labdvm/mHAT-V2/README.md

# mHAT-V2
SX1255 TMO mini-HAT with BPF

- SAW Bandpass filters:
- RX, TA0665A (https://www.aliexpress.com/item/1005011831789075.html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)
- TX, TA2490A (https://www.aliexpress.com/item/1005011831747244.html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)

# Order from here:
- <a href="https://www.pcbway.com/project/shareproject/mHAT_V2_SX1255_TMO_mini_HAT_0cc71a80.html">PCB from PCBWay</a>
