labdvm/mHAT-V2/mHAT V2.png

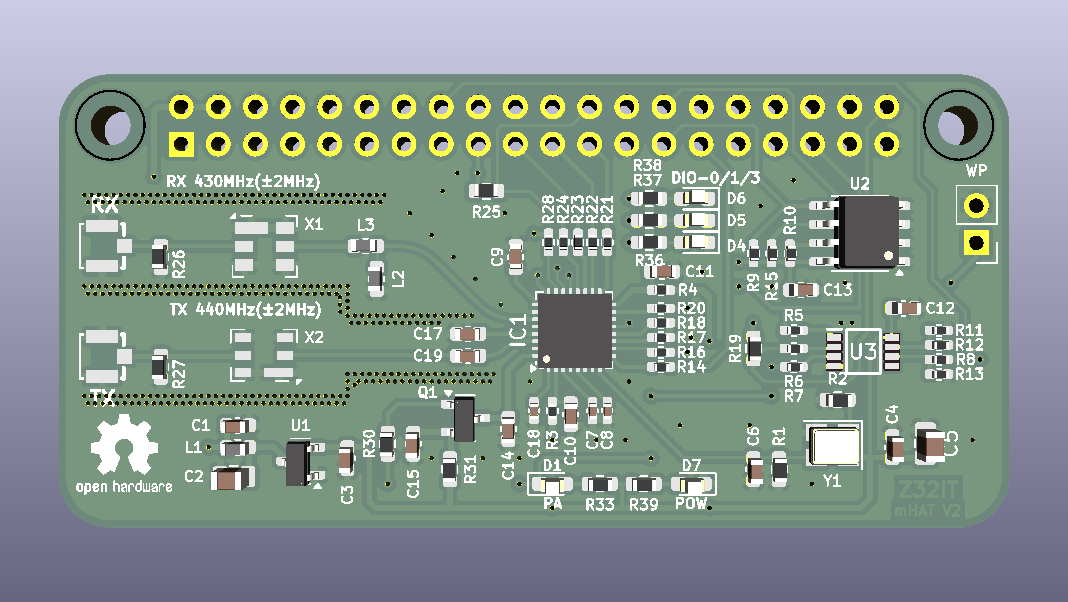
mHAT V2.png
