labdvm/mHAT-V2/mHAT V2.pdf

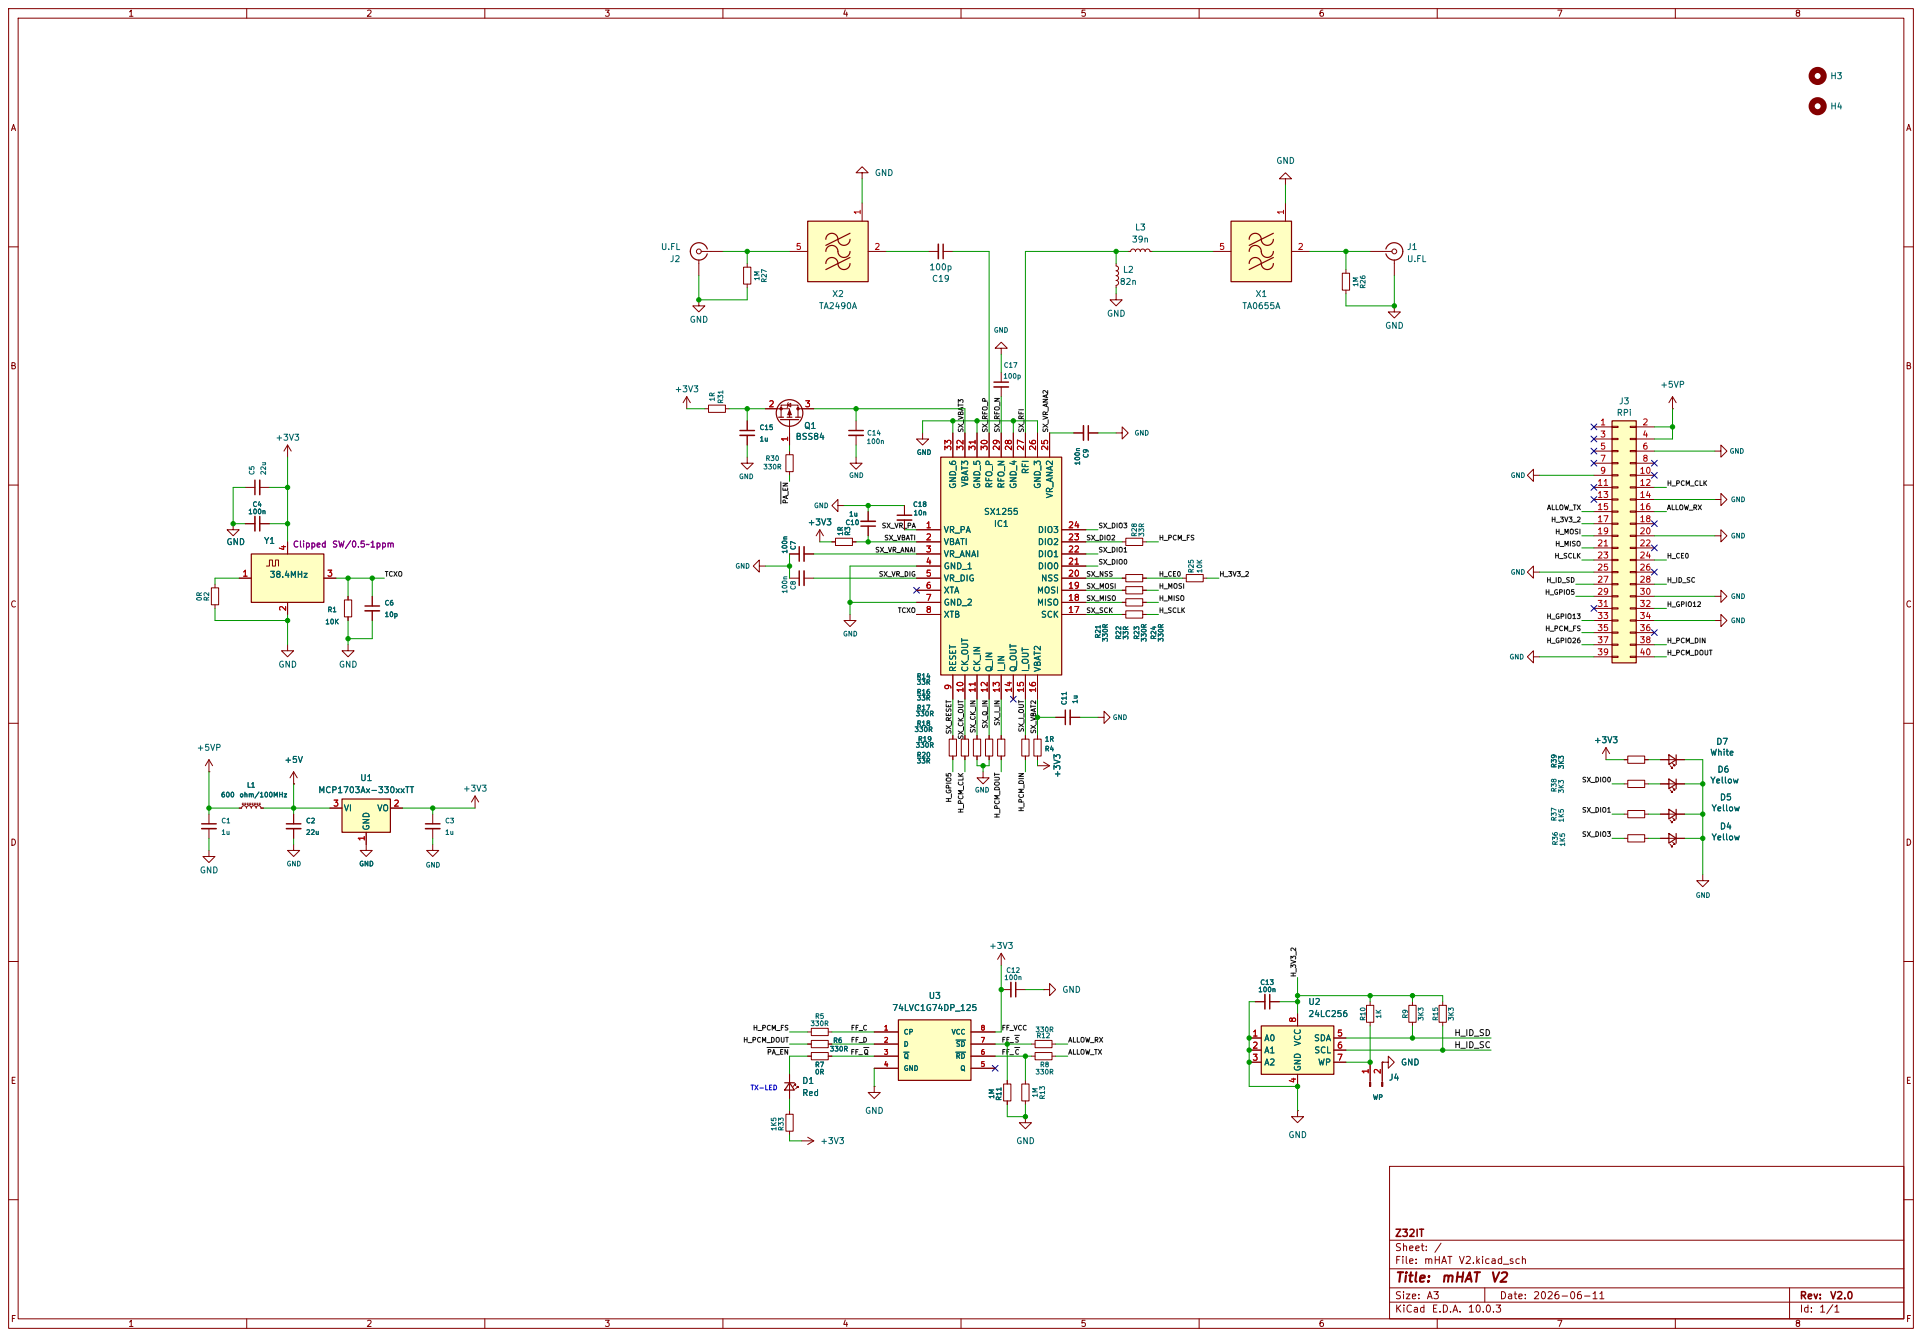
[picture p2: page 1]

Size: A3 | Rev: V2.0 | F Date: 2026-06-11
KiCad E.D.A. 10.0.3 | Id: 1/1
