labdvm/mHAT-V2/mHAT V2.kicad_pcb

## KiCad design mHAT V2.kicad_pcb (2026-06-11)

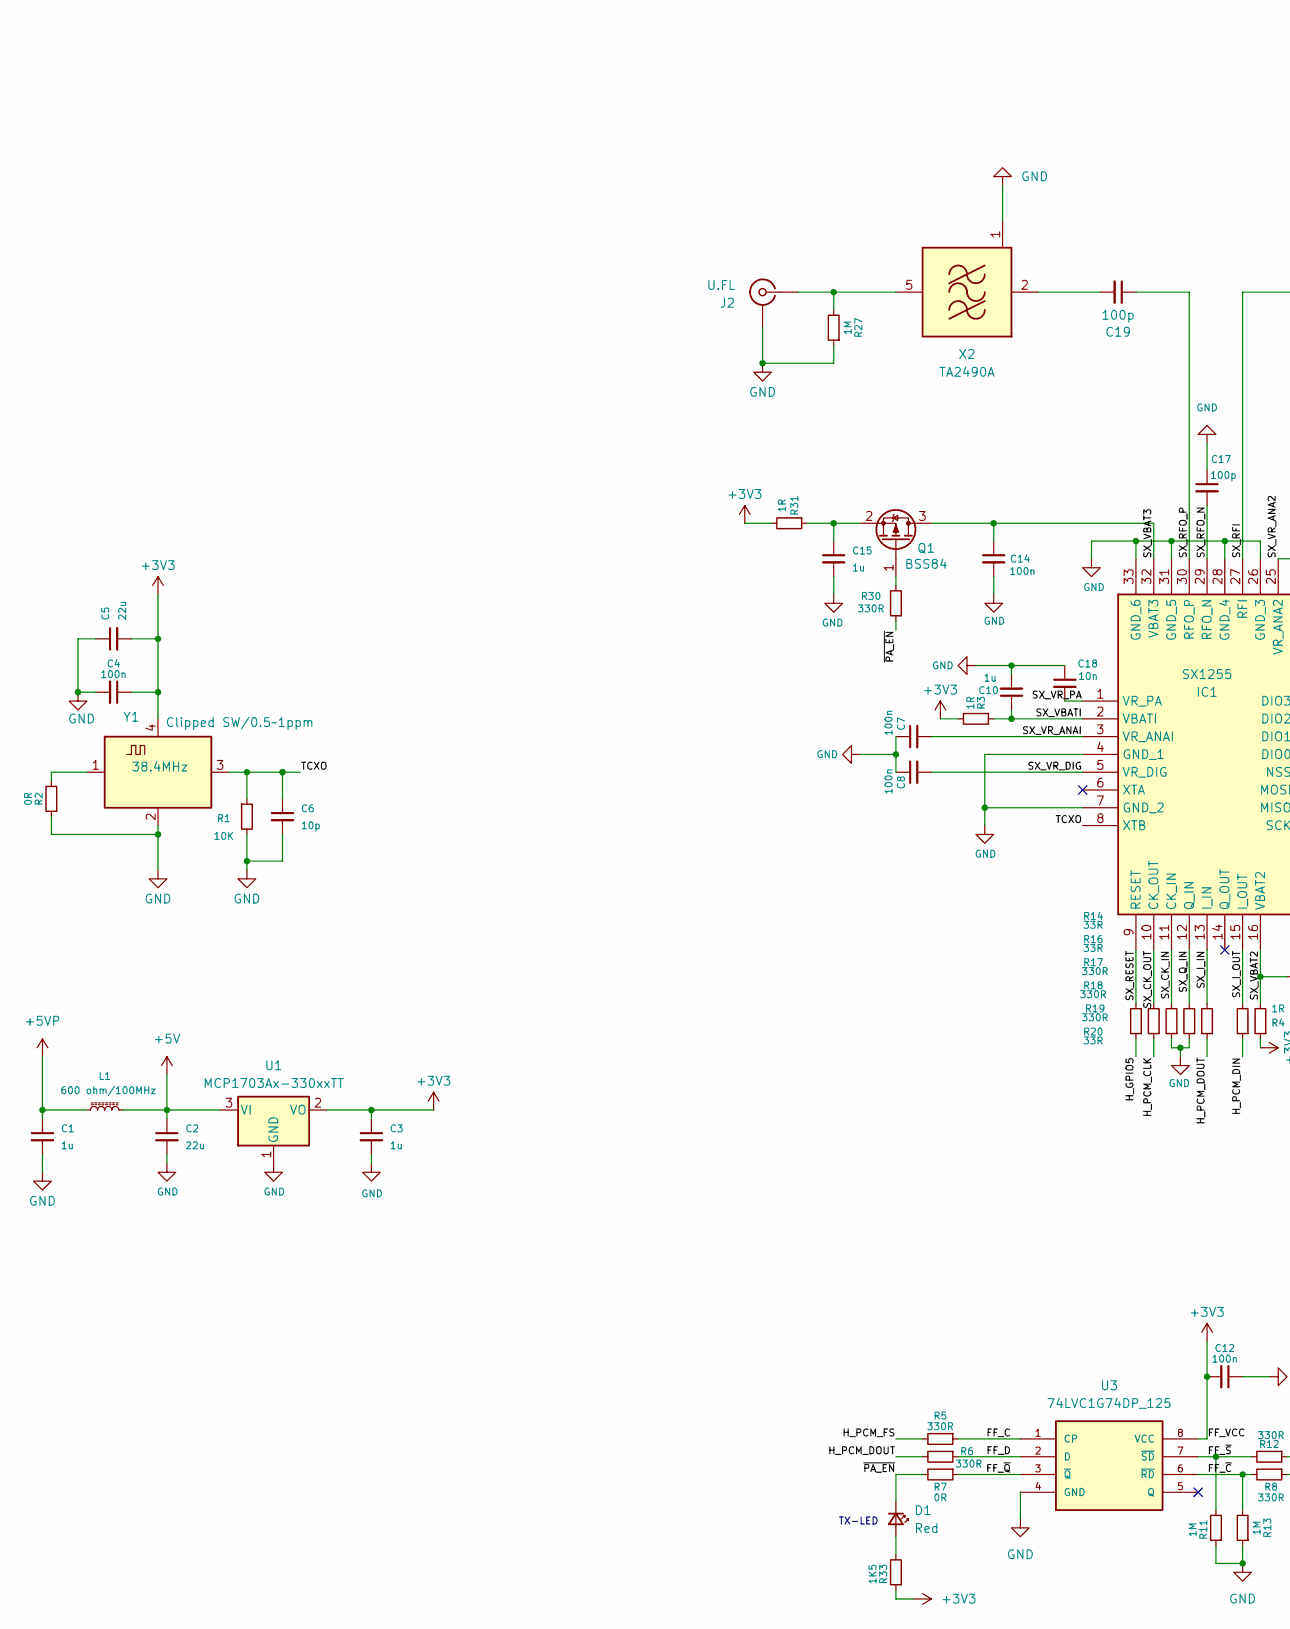
[picture p3: schematic mHAT V2.kicad_sch, part in row 1, column 1]

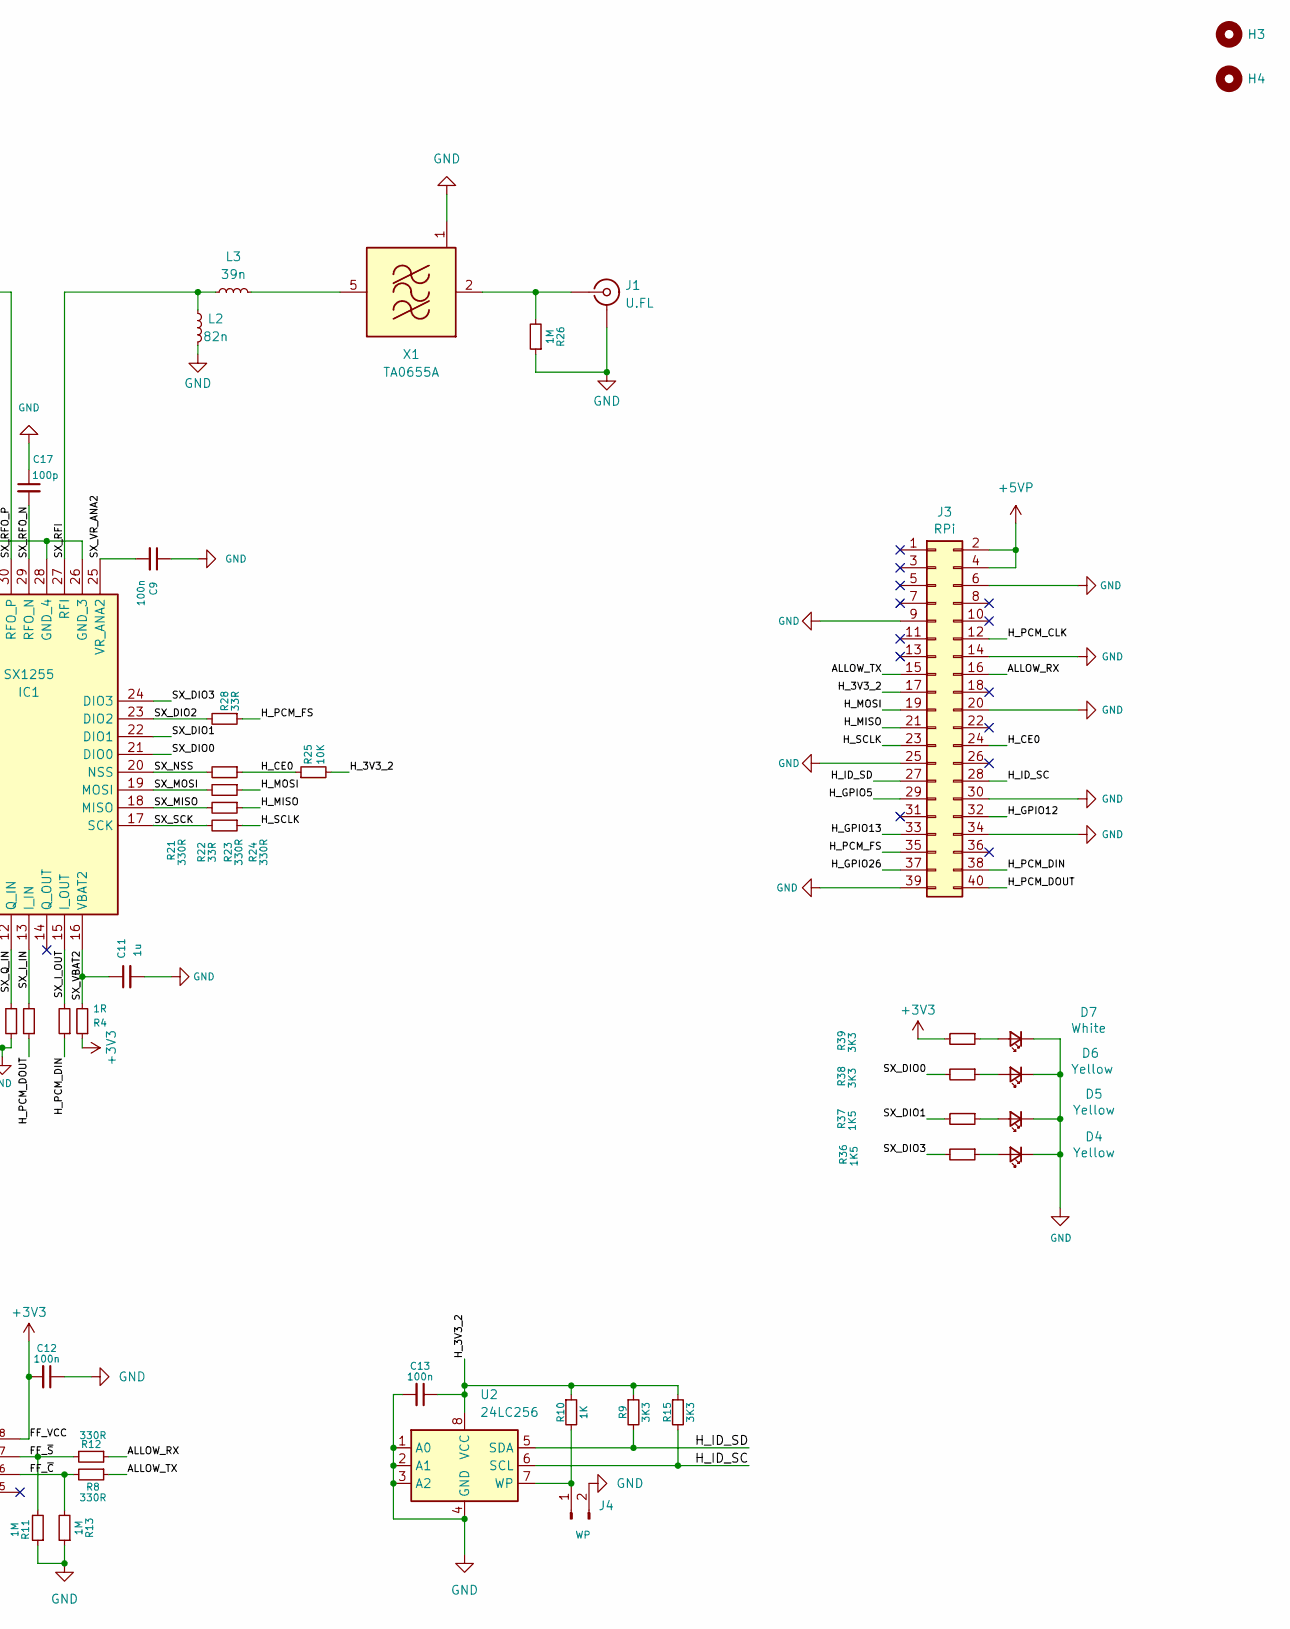
[picture p4: schematic mHAT V2.kicad_sch, part in row 1, column 2]

Parts:
C1, C3, C10, C11, C15: 1u; C_0603_1608Metric; Part Number 311-3484-1-ND
C2, C5: 22u; C_0805_2012Metric; Part Number 1276-2910-1-ND
C4, C9, C12, C13, C14: 100n; C_0603_1608Metric; Part Number 720-1688-1-ND
C6: 10p; C_0603_1608Metric; Part Number 399-14932-1-ND
C7, C8: 100n; C_0402_1005Metric_Pad0.74x0.62mm_HandSolder; Part Number 490-10777-1-ND
C17, C19: 100p; C_0603_1608Metric; Part Number 478-KGM15ACG1H101FTCT-ND
C18: 10n; C_0402_1005Metric_Pad0.74x0.62mm_HandSolder; Part Number 399-C0402C102J8HACAUTOCT-ND
D1: Red; LED_0603_1608Metric_Pad1.05x0.95mm_HandSolder; Part Number 160-1436-1-ND
D4, D5, D6: Yellow; LED_0603_1608Metric_Pad1.05x0.95mm_HandSolder; Part Number 160-1437-1-ND
D7: White; LED_0603_1608Metric_Pad1.05x0.95mm_HandSolder; Part Number 160-1724-1-ND
H3, H4: MountingHole; MountingHole_2.7mm_M2.5_DIN965
IC1: SX1255; QFN-32-1EP_5x5mm_P0.5mm_EP3.3x3.3mm_ThermalVias; Part Number SX1255IWLTRTCT-ND
J1, J2: U.FL; Part Number 343-CONMHF1-SMD-G-TCT-ND
J3: RPi; PinSocket_2x20_P2.54mm_Vertical
J4: WP; PinHeader_1x02_P2.54mm_Vertical
L1: 600 ohm/100MHz; L_0603_1608Metric; Part Number 490-1046-1-ND
L2: 82n; L_0603_1608Metric; Part Number 712-LRC0603CJ82NGV001TCT-ND
L3: 39n; L_0603_1608Metric; Part Number 712-LRC0603CJ39NGV001TCT-ND
Q1: BSS84; SOT-23; Part Number 3372-BSS84TR-ND
R1, R25: 10K; R_0603_1608Metric; Part Number 541-10.0KHCT-ND
R2: 0R; R_0603_1608Metric; Part Number 541-0.0GCT-ND
R3, R4: 1R; R_0402_1005Metric_Pad0.72x0.64mm_HandSolder; Part Number 541-RCC04021R00FKEDCT-ND
R5, R6, R8, R12, R17, R18, R21, R23, R24: 330R; R_0402_1005Metric_Pad0.72x0.64mm_HandSolder; Part Number 13-AC0402FR-7W330RLCT-ND
R7: 0R; R_0402_1005Metric_Pad0.72x0.64mm_HandSolder; Part Number 541-0.0JCT-ND
R9, R15: 3K3; R_0402_1005Metric_Pad0.72x0.64mm_HandSolder; Part Number 541-RCC04023K30FKEDCT-ND
R10: 1K; R_0402_1005Metric_Pad0.72x0.64mm_HandSolder; Part Number 13-RC0402FR-7W1KLCT-ND
R11, R13: 1M; R_0402_1005Metric_Pad0.72x0.64mm_HandSolder; Part Number 311-1.00MLRCT-ND
R14, R16, R20, R22, R28: 33R; R_0402_1005Metric_Pad0.72x0.64mm_HandSolder; Part Number 13-AC0402FR-7W33RLCT-ND
R19: 330R; R_0603_1608Metric; Part Number 13-AC0402FR-7W330RLCT-ND
R26, R27: 1M; R_0603_1608Metric; Part Number 541-1.00MHCT-ND
R30: 330R; R_0603_1608Metric; Part Number 541-330HCT-ND
R31: 1R; R_0603_1608Metric; Part Number 541-1.00HHCT-ND
R33, R36, R37: 1K5; R_0603_1608Metric; Part Number 541-1.50KHCT-ND
R38, R39: 3K3; R_0603_1608Metric; Part Number 541-3.30KHCT-ND
U1: MCP1703Ax-330xxTT; SOT-23; Part Number MCP1703AT-3302E/CBCT-ND
U2: 24LC256; SOIC-8_3.9x4.9mm_P1.27mm; Part Number 24LC256-I/SN-ND
U3: 74LVC1G74DP_125; SOP65P400X110-8N; Part Number 1727-5983-1-ND
X1: TA0655A; Filter_SAW-6_3.8x3.8mm; Part Number TA0655A
X2: TA2490A; Filter_SAW_Epcos_DCC6C_3x3mm; Part Number TA2490A
Y1: 38.4MHz; Crystal_SMD_3225-4Pin_3.2x2.5mm; Part Number 114-TG2520SMN38.4000M-MCGNNM3CT-ND

Connections:
+3V3: C3.1, C4.1, C5.2, C12.2, R3.2, R4.1, R31.2, R33.1, R39.2, U1.2 (VO), U3.8 (VCC), Y1.4 (VDD)
+5V: C2.1, L1.2, U1.3 (VI)
+5VP: C1.1, J3.2, J3.4, L1.1
/ALLOW_RX: J3.16, R12.1
/ALLOW_TX: J3.15, R8.1
/FF_C: R5.1, U3.1 (CP)
/FF_D: R6.1, U3.2 (D)
/FF_~C: R8.2, R13.2, U3.6 (~RD)
/FF_~Q: R7.1, U3.3 (~Q)
/FF_~S: R11.2, R12.2, U3.7 (~SD)
/H_3V3_2: C13.1, J3.17, R9.1, R10.1, R15.1, R25.2, U2.8 (VCC)
/H_CE0: J3.24, R24.1, R25.1
/H_GPIO5: J3.29, R14.1
/H_GPIO12: J3.32
/H_GPIO13: J3.33
/H_GPIO26: J3.37
/H_ID_SC: J3.28, R15.2, U2.6 (SCL)
/H_ID_SD: J3.27, R9.2, U2.5 (SDA)
/H_MISO: J3.21, R22.1
/H_MOSI: J3.19, R23.1
/H_PCM_CLK: J3.12, R16.1
/H_PCM_DIN: J3.38, R20.1
/H_PCM_DOUT: J3.40, R6.2, R19.1
/H_PCM_FS: J3.35, R5.2, R28.1
/H_SCLK: J3.23, R21.1
/SX_CK_IN: IC1.11 (CK_IN), R17.2
/SX_CK_OUT: IC1.10 (CK_OUT), R16.2
/SX_DIO0: IC1.21 (DIO0), R38.2
/SX_DIO1: IC1.22 (DIO1), R37.2
/SX_DIO2: IC1.23 (DIO2), R28.2
/SX_DIO3: IC1.24 (DIO3), R36.2
/SX_I_IN: IC1.13 (I_IN), R19.2
/SX_I_OUT: IC1.15 (I_OUT), R20.2
/SX_MISO: IC1.18 (MISO), R22.2
/SX_MOSI: IC1.19 (MOSI), R23.2
/SX_NSS: IC1.20 (NSS), R24.2
/SX_Q_IN: IC1.12 (Q_IN), R18.2
/SX_RESET: IC1.9 (RESET), R14.2
/SX_RFI: IC1.27 (RFI), L2.2, L3.2
/SX_RFO_N: C17.2, IC1.29 (RFO_N)
/SX_RFO_P: C19.1, IC1.30 (RFO_P)
/SX_SCK: IC1.17 (SCK), R21.2
/SX_VBAT2: C11.1, IC1.16 (VBAT2), R4.2
/SX_VBAT3: C14.1, IC1.32 (VBAT3), Q1.3 (D)
/SX_VBATI: C10.1, IC1.2 (VBATI), R3.1
/SX_VR_ANA2: C9.2, IC1.25 (VR_ANA2)
/SX_VR_ANAI: C7.2, IC1.3 (VR_ANAI)
/SX_VR_DIG: C8.2, IC1.5 (VR_DIG)
/SX_VR_PA: C18.2, IC1.1 (VR_PA)
/TCXO: C6.1, IC1.8 (XTB), R1.1, Y1.3 (OUT)
/~PA_EN: D1.1 (K), R7.2, R30.1
GND: C1.2, C2.2, C3.2, C4.2, C5.1, C6.2, C7.1, C8.1, C9.1, C10.2, C11.2, C12.1, C13.2, C14.2, C15.2, C17.1, C18.1, D4.1 (K), D5.1 (K), D6.1 (K), D7.1 (K), IC1.4 (GND_1), IC1.7 (GND_2), IC1.26 (GND_3), IC1.28 (GND_4), IC1.31 (GND_5), IC1.33 (GND_6), J1.2 (Ext), J2.2 (Ext), J3.6, J3.9, J3.14, J3.20, J3.25, J3.30, J3.34, J3.39, J4.2, L2.1, R1.2, R2.1, R11.1, R13.1, R17.1, R18.1, R26.1, R27.1, U1.1 (GND), U2.1 (A0), U2.2 (A1), U2.3 (A2), U2.4 (GND), U3.4 (GND), X1.1 (GND), X1.3 (GND), X1.4 (GND), X1.6 (GND), X2.1 (GND), X2.3 (GND), X2.4 (GND), X2.6 (GND), Y1.2 (GND)
unnamed: D1.2 (A), R33.2
unnamed: D4.2 (A), R36.1
unnamed: D5.2 (A), R37.1
unnamed: D6.2 (A), R38.1
unnamed: D7.2 (A), R39.1
unnamed: J1.1 (In), R26.2, X1.2 (IN)
unnamed: J2.1 (In), R27.2, X2.5 (OUT)
unnamed: J4.1, R10.2, U2.7 (WP)
unnamed: Q1.1 (G), R30.2
unnamed: C15.1, Q1.2 (S), R31.1
unnamed: L3.1, X1.5 (OUT)
unnamed: C19.2, X2.2 (IN)
unnamed: R2.2, Y1.1 (Tri-State)

Notes on the sheet:
TX-LED

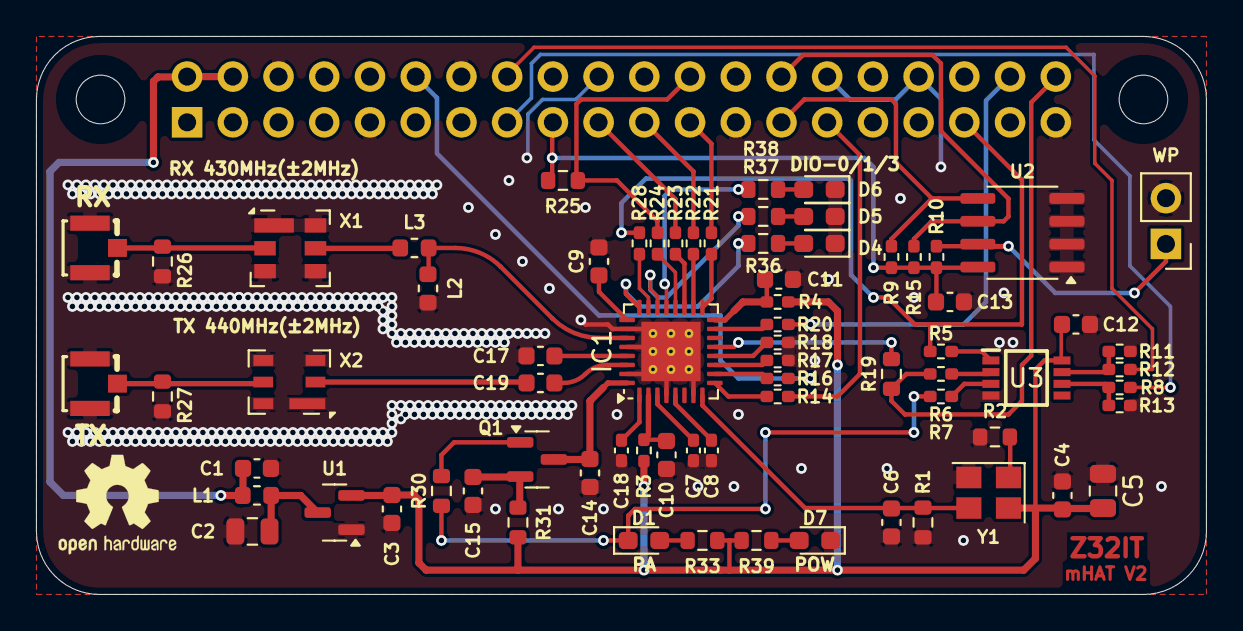
[picture p5: board mHAT V2.kicad_pcb from above]

Board: 2 copper layers, 65.0 x 31.0 mm, 75 parts (1 on the bottom side), 62 nets.
