labdvm/mHAT-V2/(commit log)

2026-06-18 Add ordering information to README
    Added order link for mHAT-V2 from PCBWay.
2026-10-30 Update README with RX and TX filter links
    Added links for RX and TX bandpass filters in the README.
